BeeEyeIoT/microsensor-board/microsensor.kicad_pcb

## KiCad design microsensor.kicad_pcb (2026-10-28)

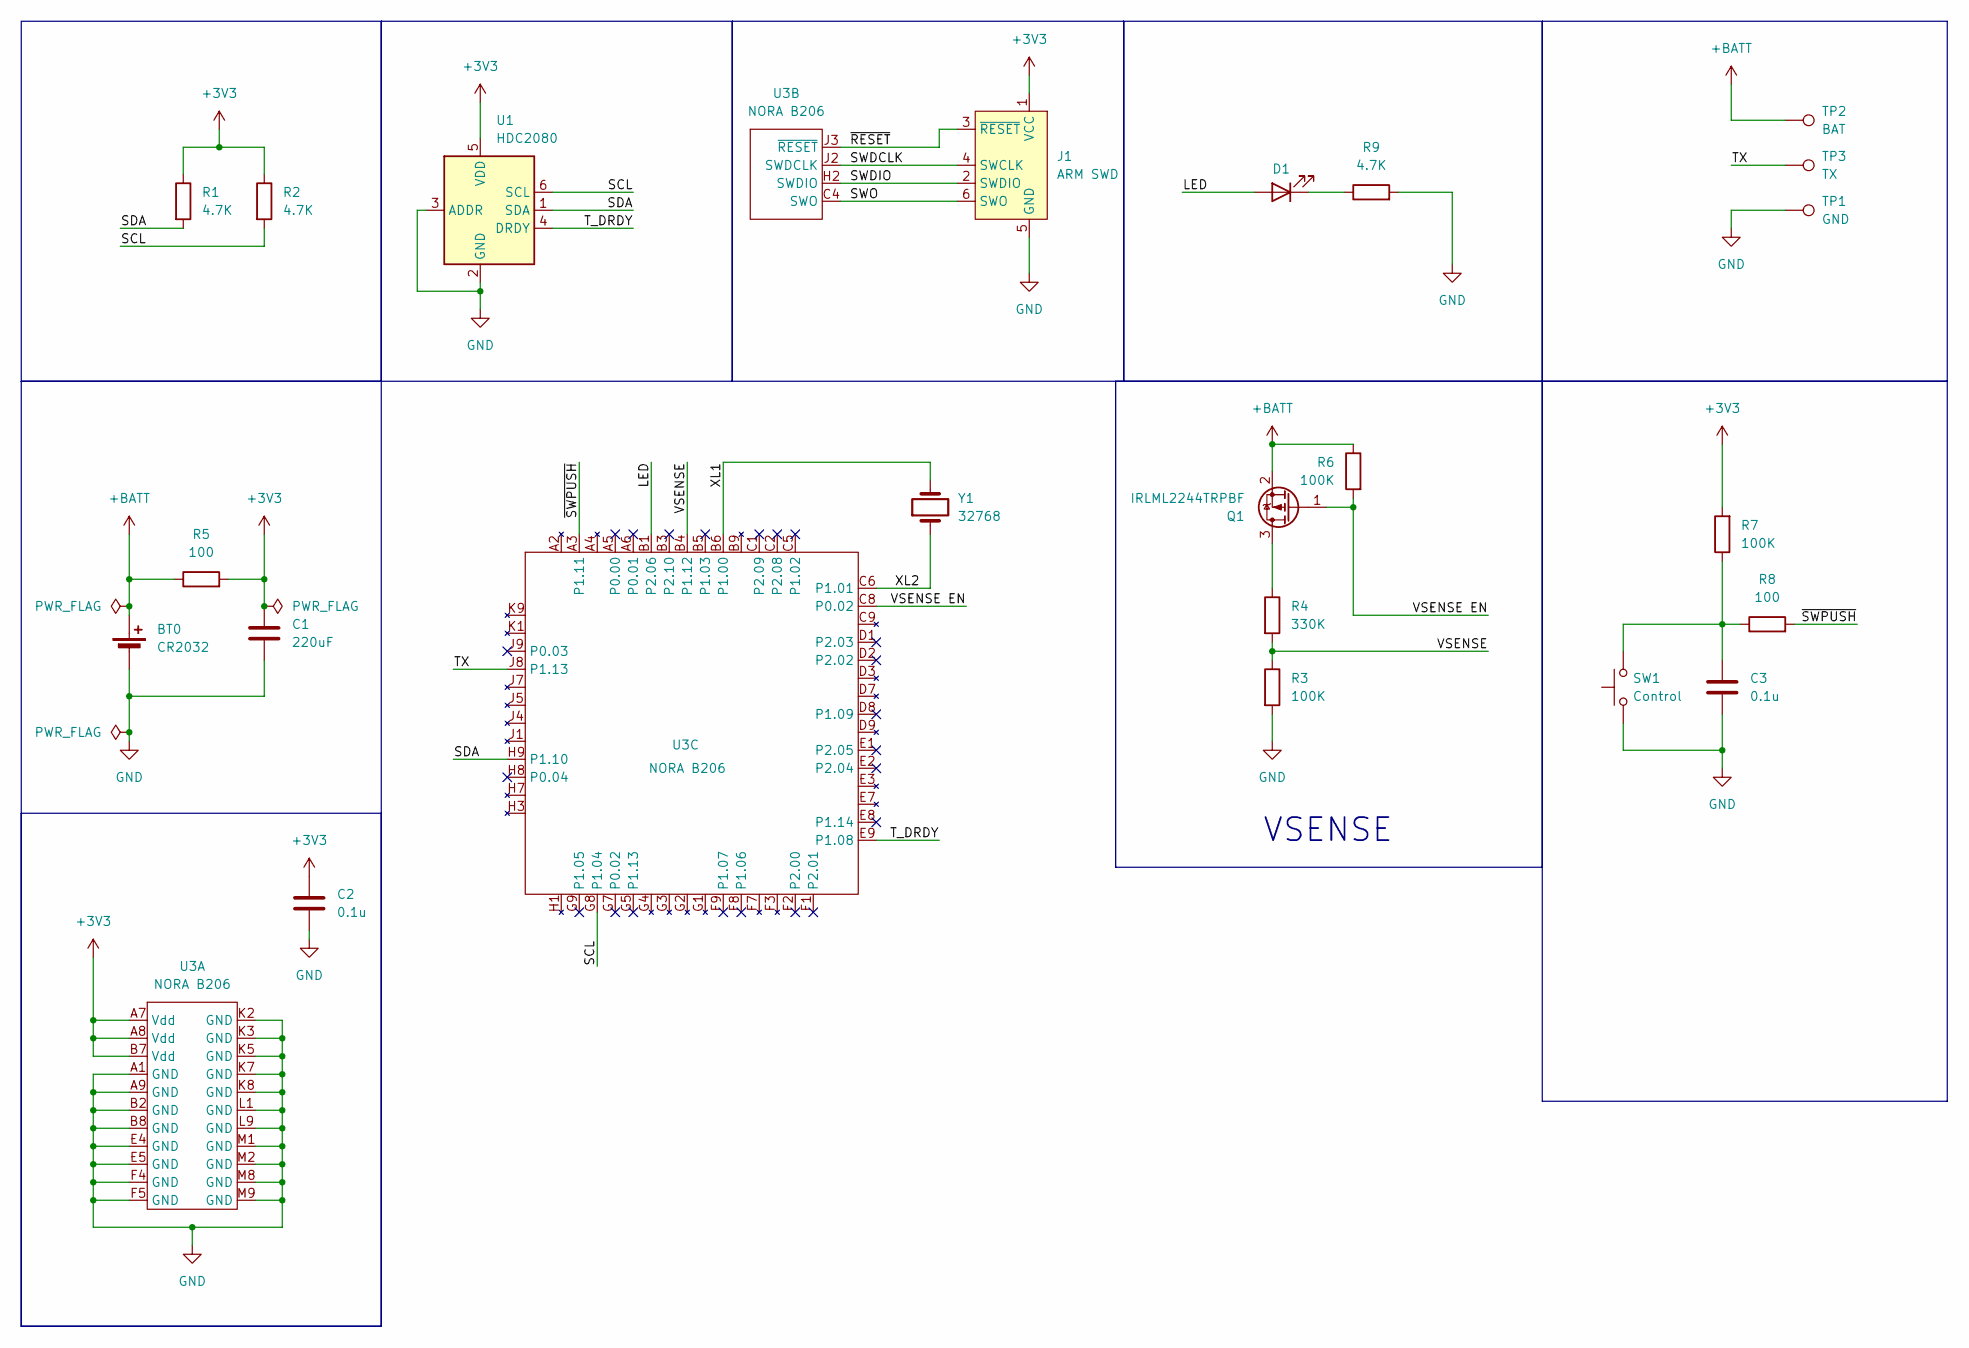
[picture p1: schematic microsensor.kicad_sch]

Parts:
BT0: CR2032; Keystone 110 and 112 for CR20xx
C1: 220uF; C_1206_3216Metric
C2, C3: 0.1u; C_0805_2012Metric
D1: LED; LED_1206_3216Metric
J1: ARM SWD; Tag-Connect_TC2030-IDC-NL_2x03_P1.27mm_Vertical
Q1: IRLML2244TRPBF; SOT-23
R1, R2, R9: 4.7K; R_0805_2012Metric
R3, R6, R7: 100K; R_0805_2012Metric
R4: 330K; R_0805_2012Metric
R5, R8: 100; R_0805_2012Metric
SW1: Control; B3U-1000P
TP1: GND; TestPoint_Pad_1.5x1.5mm
TP2: BAT; TestPoint_Pad_1.5x1.5mm
TP3: TX; TestPoint_Pad_1.5x1.5mm
U1: HDC2080; Texas_S-PWSON-N6-HDC2080
U3: NORA B206; NORA-B2x6
Y1: 32768; Crystal_SMD_2012-2Pin_2.0x1.2mm

Connections:
+3V3: C1.1, C2.1, J1.1 (VCC), R1.1, R2.1, R5.2, R7.2, U1.5 (VDD), U3.A7 (Vdd), U3.A8 (Vdd), U3.B7 (Vdd)
+BATT: BT0.1 (+), Q1.2 (S), R5.1, R6.1, TP2.1 (1_1)
/LED: D1.2 (A), U3.B1 (P2.06)
/SCL: R2.2, U1.6 (SCL), U3.G8 (P1.04)
/SDA: R1.2, U1.1 (SDA), U3.H9 (P1.10)
/SWDCLK: J1.4 (SWCLK), U3.J2 (SWDCLK)
/SWDIO: J1.2 (SWDIO), U3.H2 (SWDIO)
/SWO: J1.6 (SWO), U3.C4 (SWO)
/TX: TP3.1 (1_1), U3.J8 (P1.13)
/T_DRDY: U1.4 (DRDY), U3.E9 (P1.08)
/VSENSE: R3.1, R4.2, U3.B4 (P1.12)
/VSENSE EN: Q1.1 (G), R6.2, U3.C8 (P0.02)
/XL1: U3.B6 (P1.00), Y1.2
/XL2: U3.C6 (P1.01), Y1.1
/~RESET: J1.3 (~RESET), U3.J3 (~RESET)
/~SWPUSH: R8.2, U3.A3 (P1.11)
GND: BT0.2 (-), C1.2, C2.2, C3.2, J1.5 (GND), R3.2, R9.2, SW1.1, TP1.1 (1_1), U1.2 (GND), U1.3 (ADDR), U3.A1 (GND), U3.A9 (GND), U3.B2 (GND), U3.B8 (GND), U3.E4 (GND), U3.E5 (GND), U3.F4 (GND), U3.F5 (GND), U3.K2 (GND), U3.K3 (GND), U3.K5 (GND), U3.K7 (GND), U3.K8 (GND), U3.L1 (GND), U3.L9 (GND), U3.M1 (GND), U3.M2 (GND), U3.M8 (GND), U3.M9 (GND)
unnamed: C3.1, R7.1, R8.1, SW1.2
unnamed: D1.1 (K), R9.1
unnamed: Q1.3 (D), R4.1

Notes on the sheet:
VSENSE

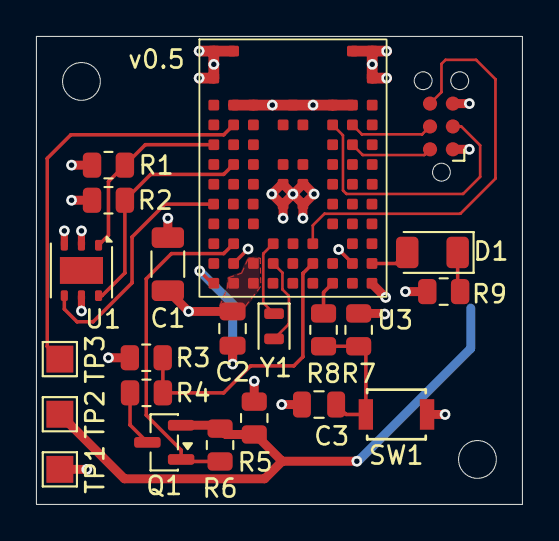
[picture p2: board microsensor.kicad_pcb from above]

Board: 4 copper layers, 27.0 x 26.0 mm, 25 parts (1 on the bottom side), 20 nets.

Other parts of the board:
MH1, MH2: MountingHole_2.1mm
