BeeEyeIoT/microsensor-board/(commit log)

2026-09-28 Remove RV3028 (firmware will use GRTC)
    [BOM.csv, DigiKey List.csv, microsensor.kicad_pcb, microsensor.kicad_sch]
2026-09-28 Put TP together, minor refactors, added more dimensions
    [microsensor.kicad_pcb, microsensor.kicad_sch]
2026-10-28 clean up footprint lib
2026-10-28 add solder mask expansion (0.051)
